RonHooo/bracket-fea/cad/results/portfolio_bracket.png

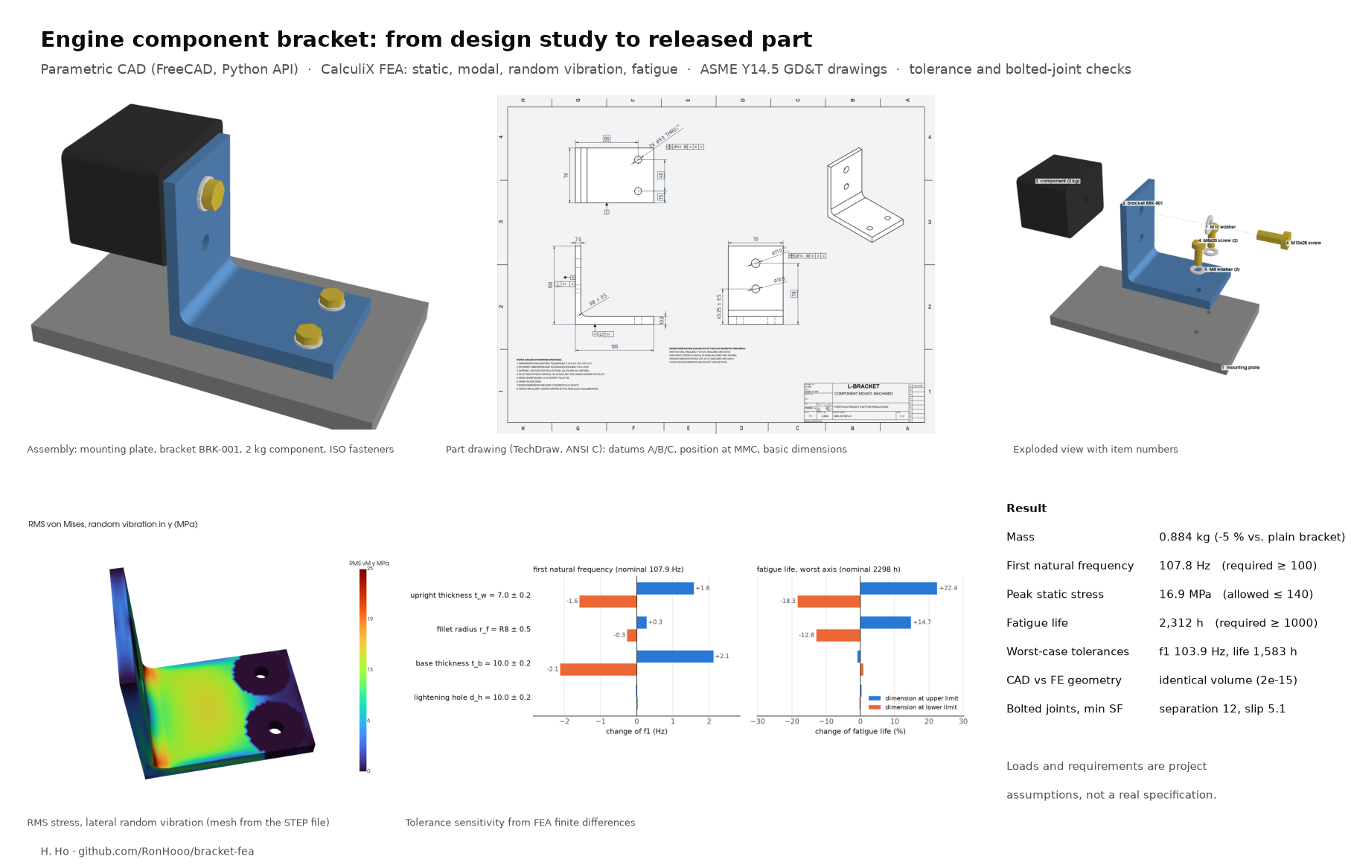
cad/results/portfolio_bracket.png
