RonHooo/bracket-fea/results/designs/baseline/mesh.png

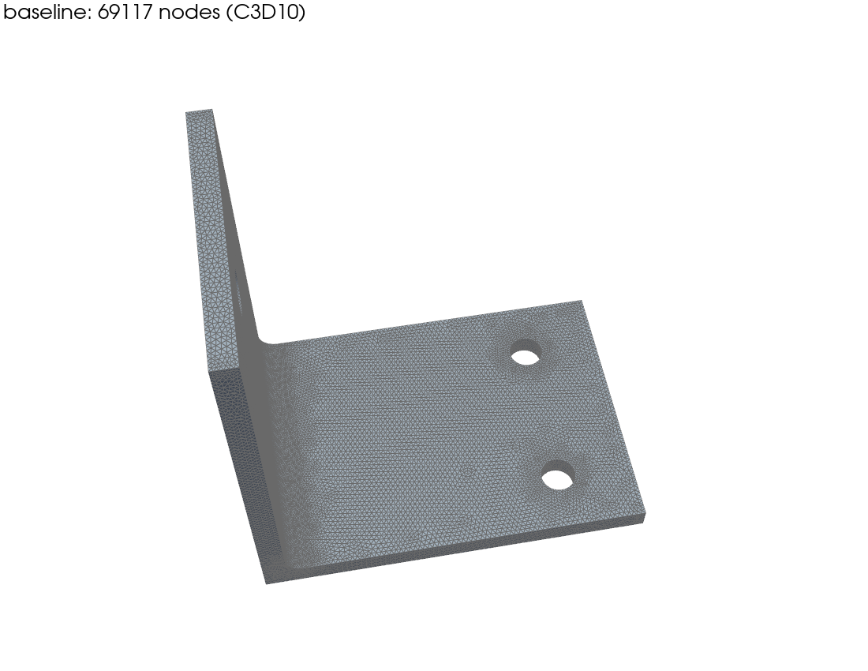
results/designs/baseline/mesh.png
