RonHooo/bracket-fea/results/designs/baseline/mode1.png

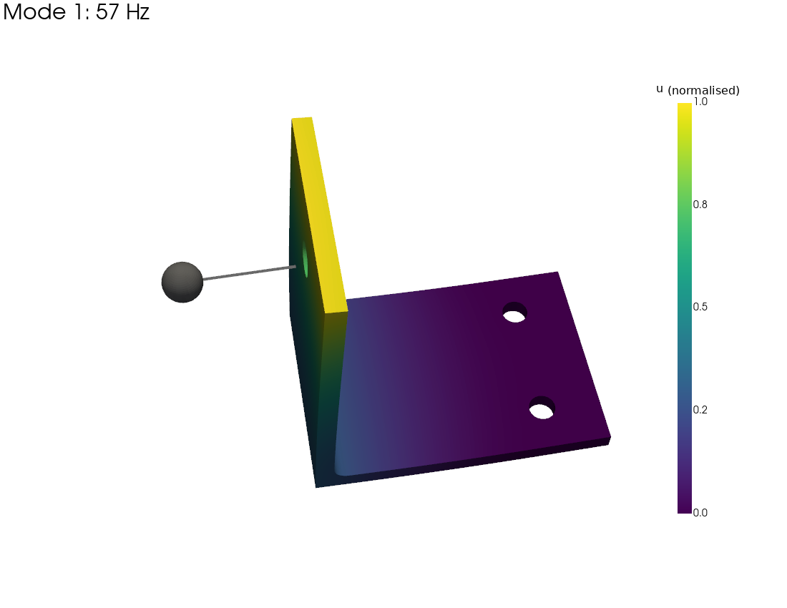
results/designs/baseline/mode1.png
