RonHooo/bracket-fea/results/designs/baseline/psd.png

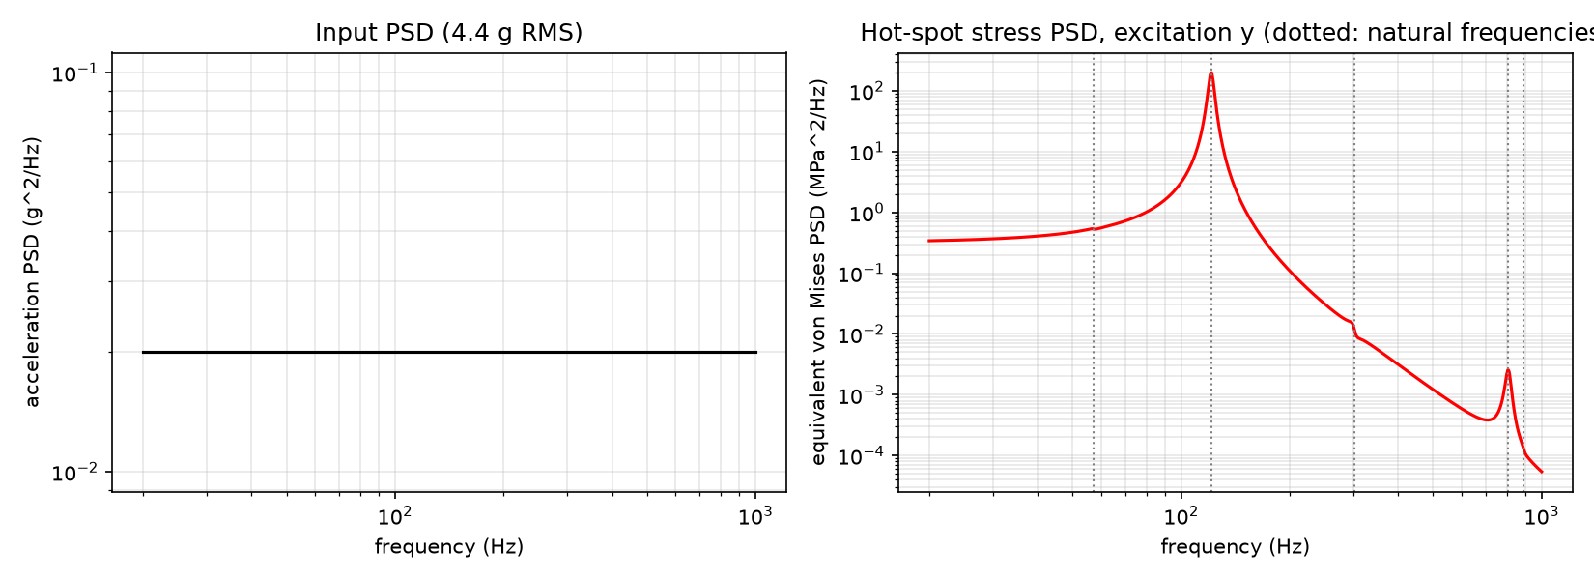
results/designs/baseline/psd.png
