RonHooo/bracket-fea/results/designs/optimum/psd.png

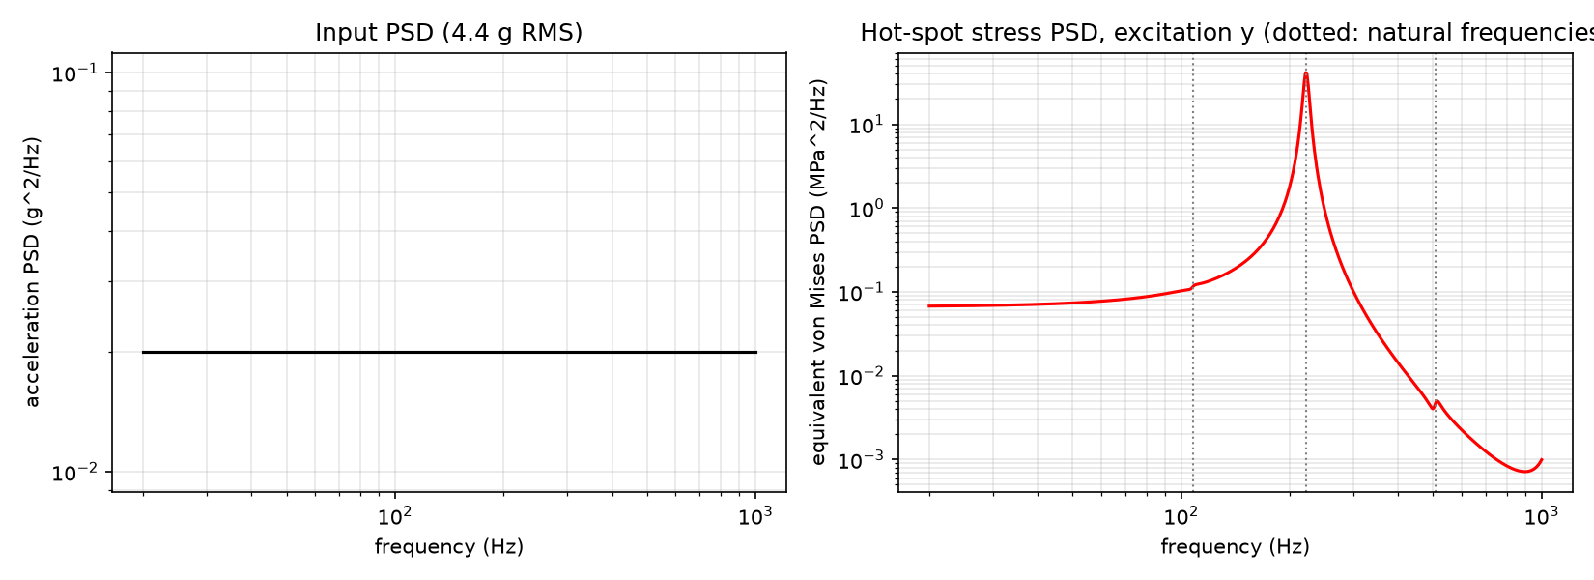
results/designs/optimum/psd.png
