RonHooo/bracket-fea/results/designs/screened_best/mesh.png

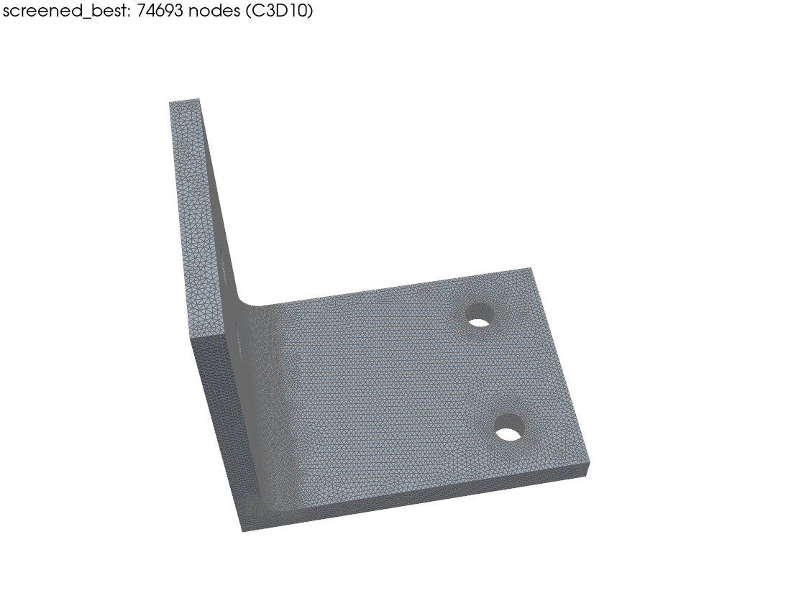
results/designs/screened_best/mesh.png
