RonHooo/bracket-fea/results/verification/v3_spectral_fatigue.png

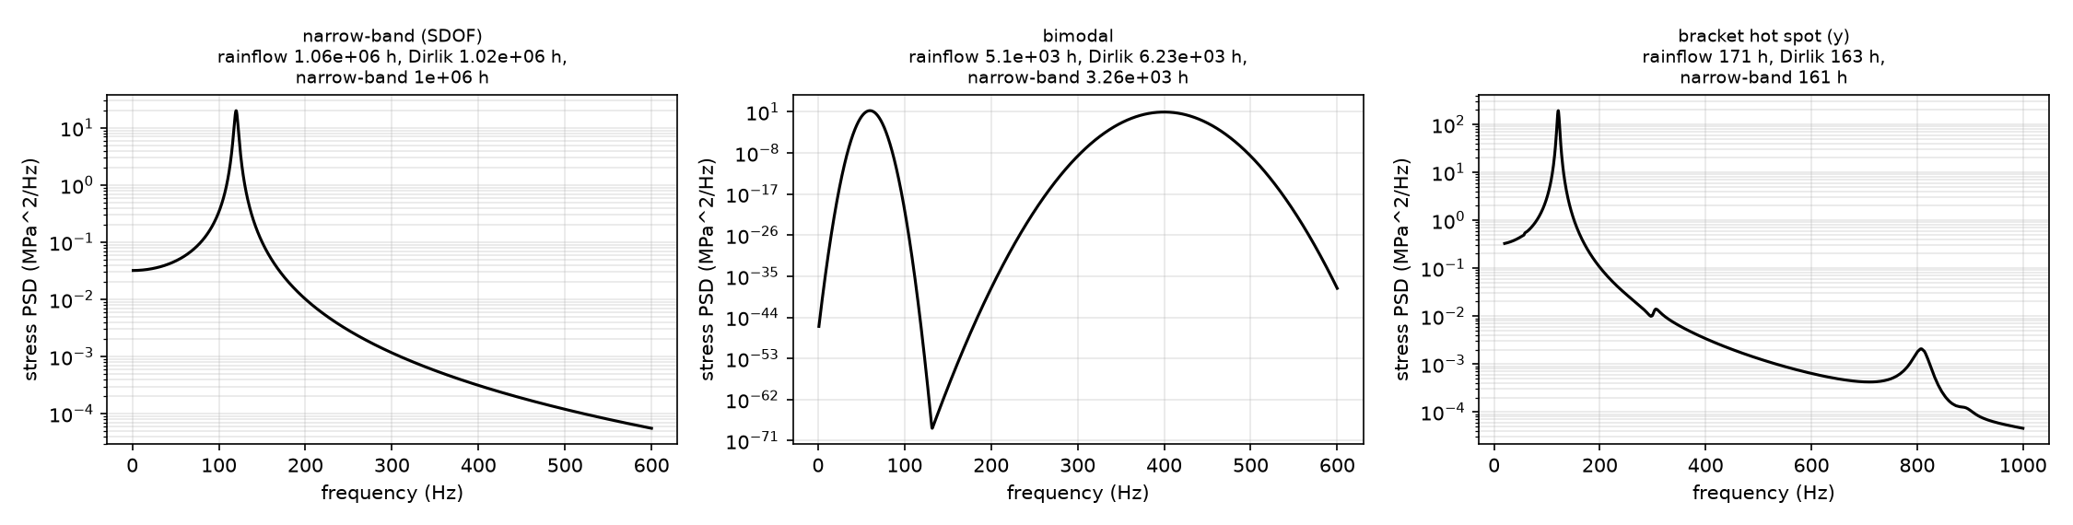
results/verification/v3_spectral_fatigue.png
