RonHooo/bracket-fea/results/optimization/doe_analysis.csv

id | split | t_b | t_w | r_f | L_g | t_g | d_h | mass_kg | vm_max | f1 | f2 | n_nodes | hot_x | hot_y | hot_z | vm_rms_x | life_x_h | vm_rms_y | life_y_h | vm_rms_z | life_z_h | life_h | ok_stress | ok_freq | ok_life | feasible | t_mesh | t_solve | t_parse | t_random | status | vm_max_corner | t_total | ok_life_margin | feasible_margin | gussets | hot_spot
0 | doe | 10.491 | 4.854 | 7.234 | 33.549 | 6.464 | 0.0 | 0.8649765028650915 | 31.17174199776336 | 113.7559 | 235.207 | 71804 | 5.006240934977418 | -24.626285714285693 | 44.10306026001603 | 51.818403576487505 | 10.71829919481946 | 42.69433689501009 | 37.432078286803794 | 58.970350998083404 | 4.436938331240079 | 4.436938331240079 | True | True | False | False | 1.4791292500158306 | 72.6704906670202 | 1.3351316249754746 | 7.361037500028033 | ok | 26.89751146939066 | 83.09834279198549 | False | False | with gussets | gusset tip (on upright)
1 | doe | 8.788 | 4.088 | 8.631 | 32.423 | 5.175 | 13.843 | 0.722956368719305 | 47.12260726848526 | 84.38934 | 179.2263 | 82495 | 4.239895010019635 | -26.93751713125306 | 41.27489593113165 | 70.11977161077186 | 1.4308223184157955 | 57.69585853519348 | 4.939718481326692 | 78.15050105158119 | 0.6561982661966446 | 0.6561982661966446 | True | False | False | False | 1.47461887501413 | 80.14233383297687 | 1.6282844580127858 | 11.082739042001776 | ok | 44.557732651722176 | 94.57847220799886 | False | False | with gussets | gusset tip (on upright)
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
