RonHooo/bracket-fea/cad/out/assembly/bracket_assembly.step

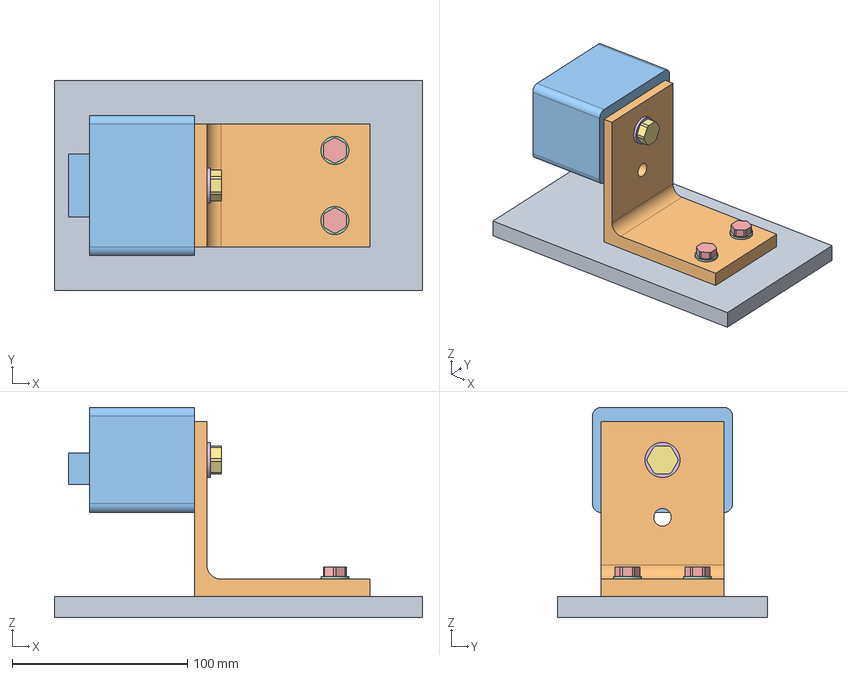
[picture p19: CAD file, 2026-11-05]
cad/out/assembly/bracket_assembly.step
210.0 x 120.0 x 120.0 mm
exp_MountingPlate
exp_Bracket
exp_Component
exp_WasherM8_1
exp_ScrewM8_1
exp_WasherM8_2
exp_ScrewM8_2
exp_WasherM10
exp_ScrewM10
