RonHooo/bracket-fea/cad/out/bracket.step

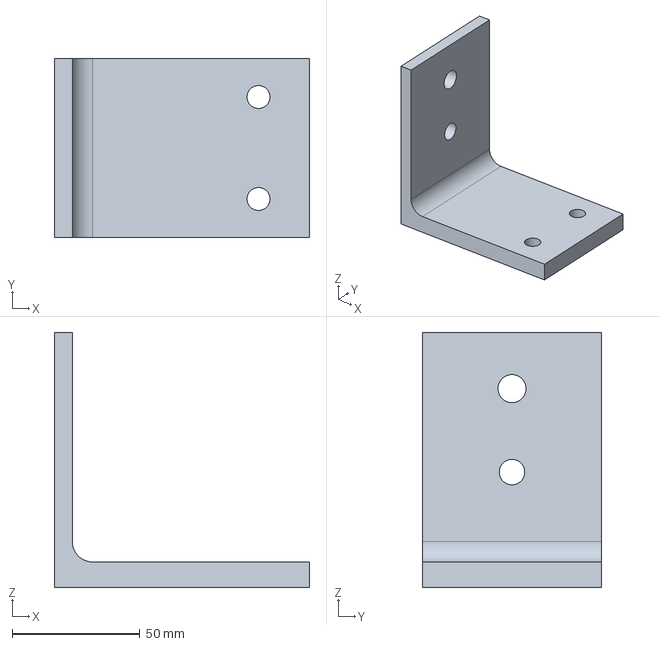
[picture p20: CAD file, 2026-11-05]
cad/out/bracket.step
100.0 x 70.0 x 100.0 mm
