RonHooo/bracket-fea/cad/out/drawings/BRK-001_drawing.FCStd

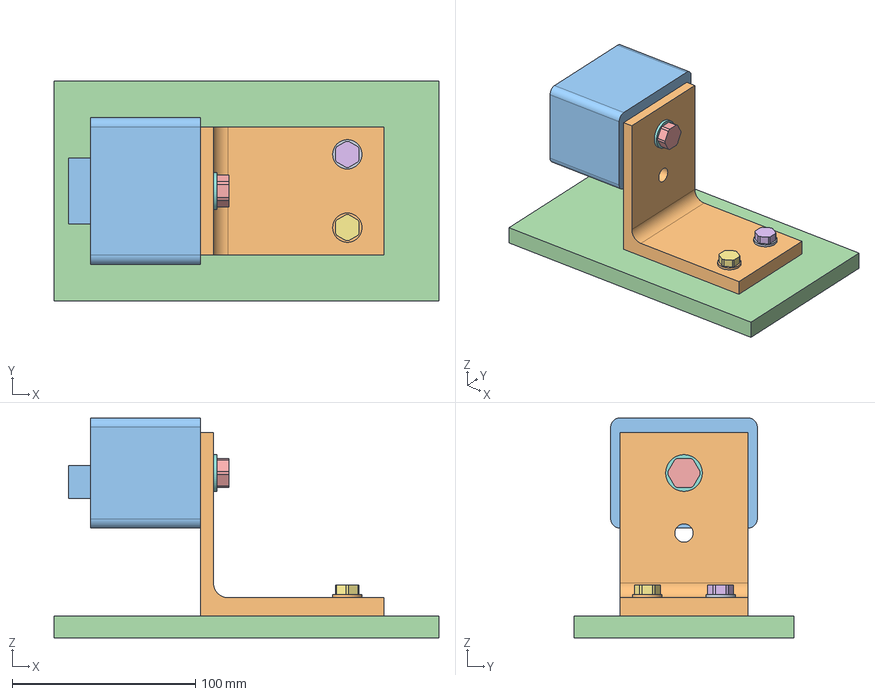
[picture p21: CAD file, 2026-11-05]
cad/out/drawings/BRK-001_drawing.FCStd
210.0 x 120.0 x 120.0 mm
Bracket
asm_Bracket
asm_Component
asm_MountingPlate
asm_ScrewM10
asm_ScrewM8_1
asm_ScrewM8_2
asm_WasherM10
asm_WasherM8_1
asm_WasherM8_2
