RonHooo/bracket-fea/cad/out/assembly/mounting_plate.FCStd

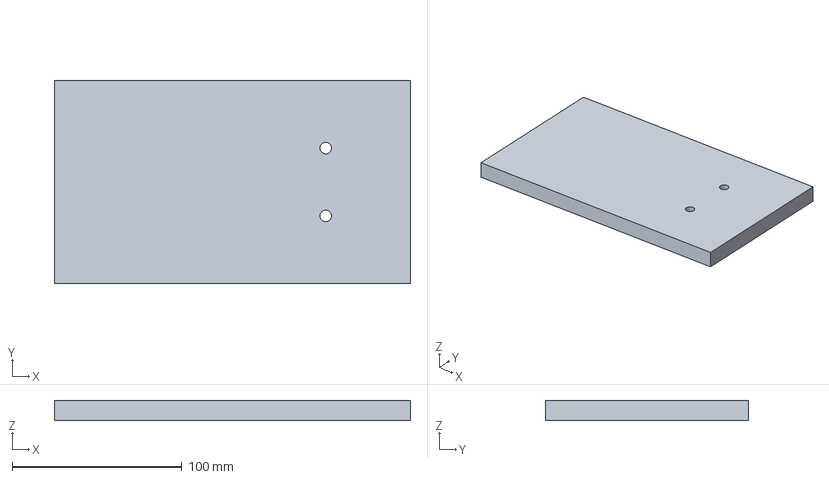
[picture p22: CAD file, 2026-11-05]
cad/out/assembly/mounting_plate.FCStd
210.0 x 120.0 x 12.0 mm
