RonHooo/bracket-fea/cad/out/assembly/component.FCStd

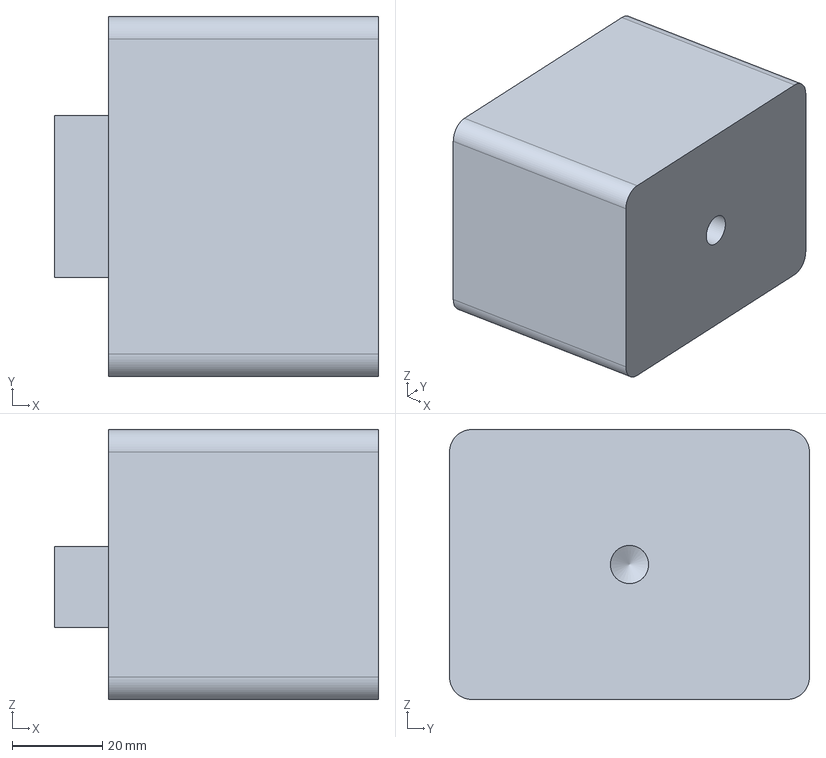
[picture p23: CAD file, 2026-11-05]
cad/out/assembly/component.FCStd
72.0 x 80.0 x 60.0 mm
