RonHooo/bracket-fea/cad/out/assembly/screw_M10x25.FCStd

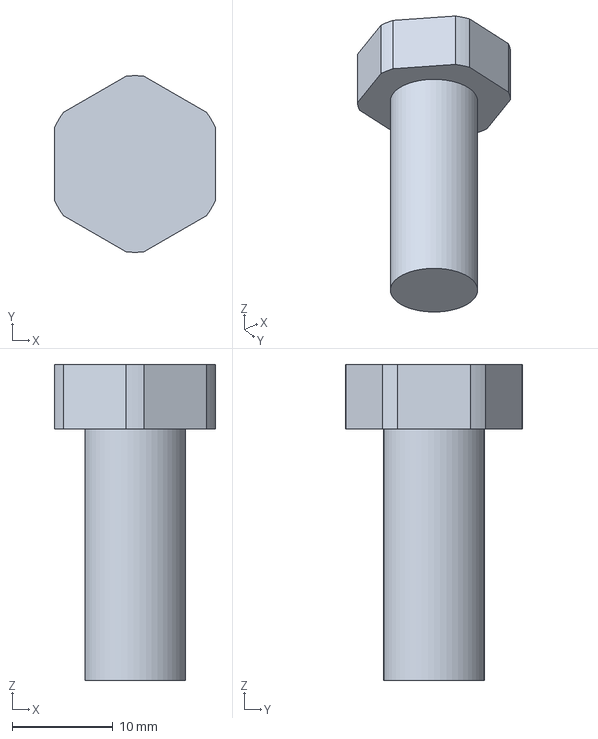
[picture p24: CAD file, 2026-11-05]
cad/out/assembly/screw_M10x25.FCStd
16.0 x 17.5 x 31.4 mm
