RonHooo/bracket-fea/cad/out/assembly/stl/ScrewM8_1.stl

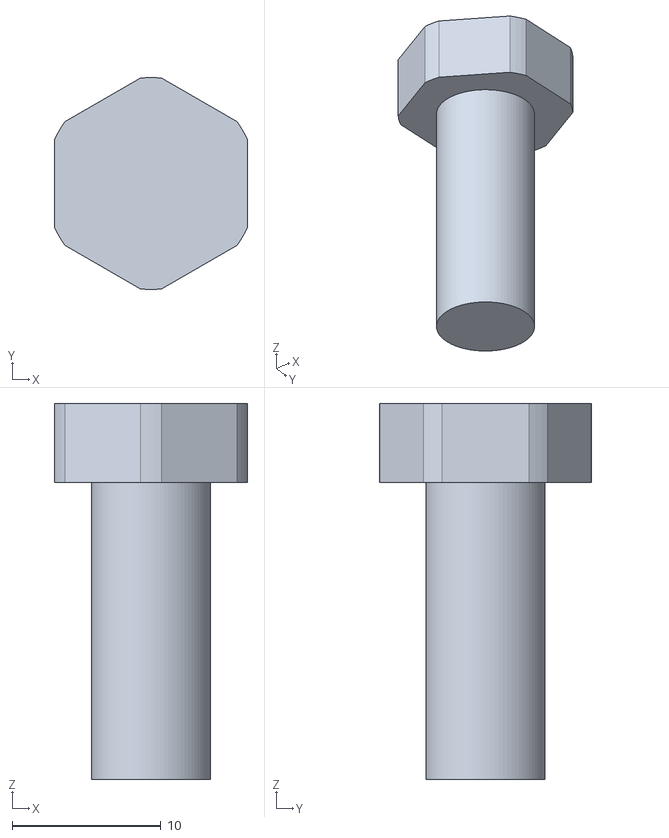
[picture p25: CAD file, 2026-11-05]
cad/out/assembly/stl/ScrewM8_1.stl
13.0 x 14.3 x 25.3
