RonHooo/bracket-fea/cad/out/assembly/stl/WasherM8_2.stl

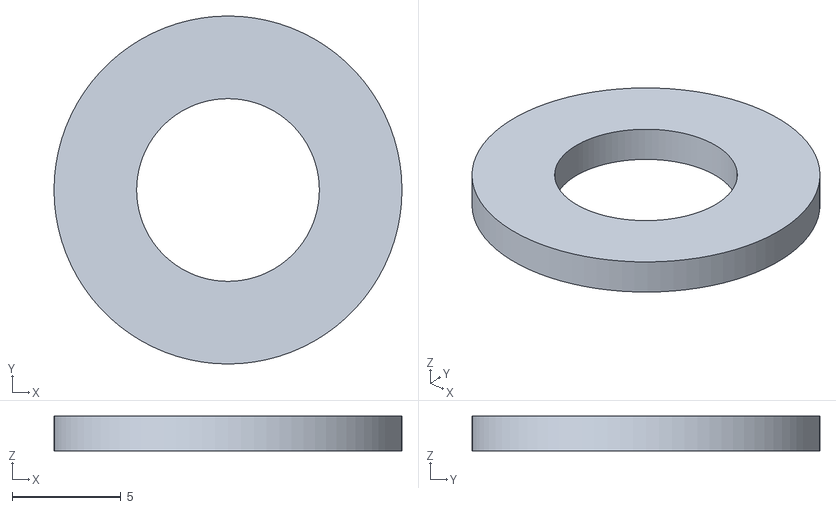
[picture p26: CAD file, 2026-11-05]
cad/out/assembly/stl/WasherM8_2.stl
16.0 x 16.0 x 1.60
