RonHooo/bracket-fea/cad/out/assembly/washer_M10.FCStd

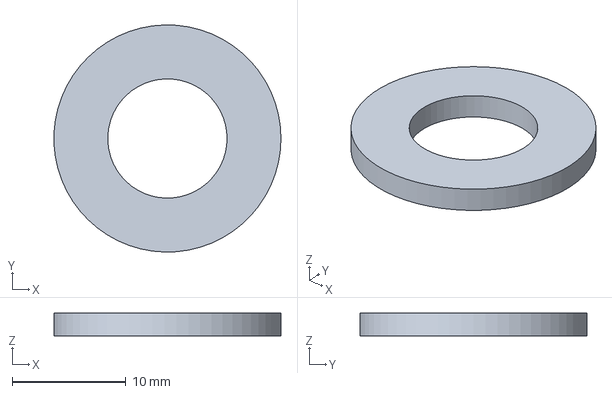
[picture p27: CAD file, 2026-11-05]
cad/out/assembly/washer_M10.FCStd
20.0 x 20.0 x 2.00 mm
