RonHooo/bracket-fea/(list of files, cad)

Other CAD files:
cad/out/assembly/bracket.FCStd
cad/out/assembly/stl/WasherM8_1.stl
cad/out/assembly/stl/ScrewM10.stl
cad/out/assembly/stl/ScrewM8_2.stl
cad/out/assembly/washer_M8.FCStd
cad/out/assembly/screw_M8x20.FCStd
cad/out/assembly/bracket_assembly.FCStd
cad/out/assembly/stl/Bracket.stl
cad/out/assembly/stl/Component.stl
cad/out/assembly/stl/MountingPlate.stl
cad/out/assembly/stl/WasherM10.stl
cad/out/bracket.FCStd
cad/out/bracket.stl
