RonHooo/bracket-fea/cad/results/figures/step_rms_von_mises_y.png

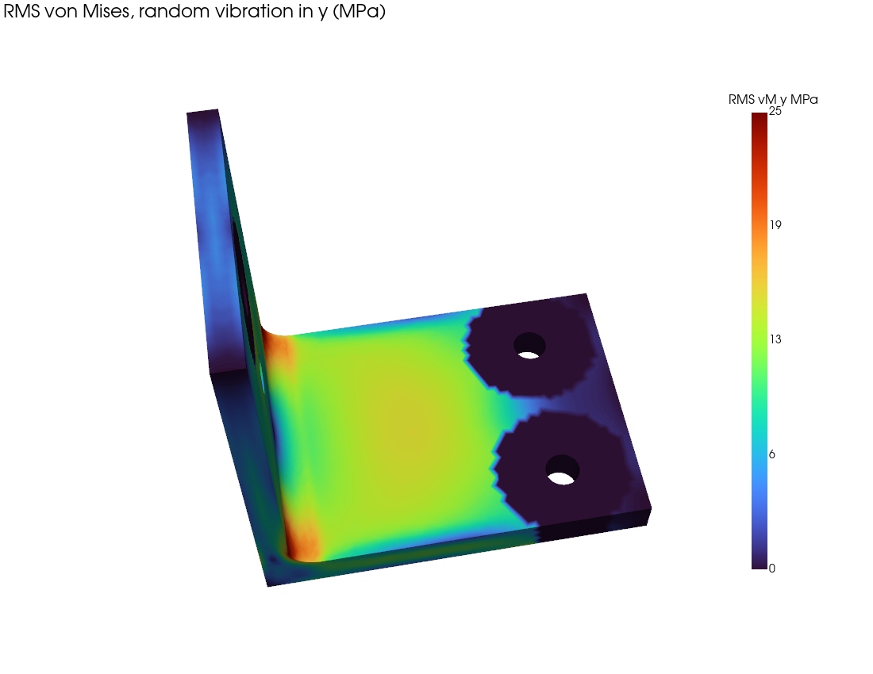
cad/results/figures/step_rms_von_mises_y.png
