RonHooo/bracket-fea/cad/results/figures/step_static_von_mises.png

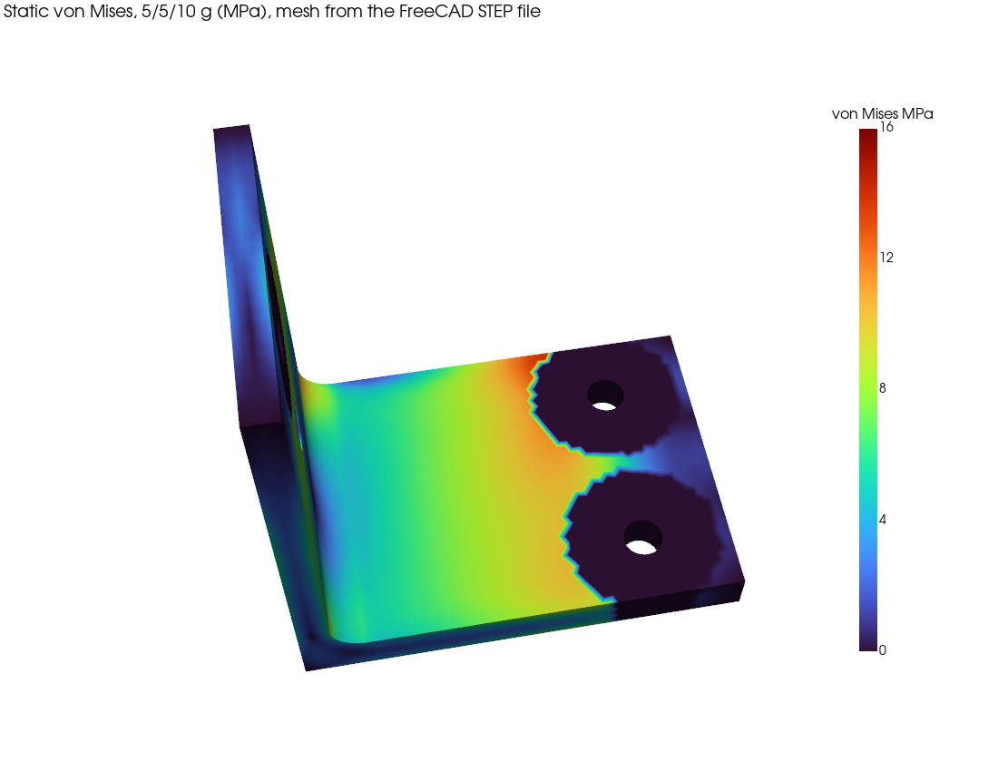
cad/results/figures/step_static_von_mises.png
