RonHooo/bracket-fea/cad/results/tolerance_runs.csv

run | t_b | t_w | r_f | d_h | f1 | life_h | log10_life | vm_max | mass_kg | n_nodes
nominal | 10.0 | 7.0 | 8.0 | 10.0 | 107.8553 | 2297.6988961734883 | 3.361293115606295 | 16.476195348506373 | 0.8837063729193229 | 30478
t_b- | 9.5 | 7.0 | 8.0 | 10.0 | 102.4471 | 2338.8111789588147 | 3.3689951609941002 | 18.345268681551527 | 0.8586540183415194 | 30283
t_b+ | 10.5 | 7.0 | 8.0 | 10.0 | 113.044 | 2236.9453633916364 | 3.3496553767352983 | 16.668525600060462 | 0.908758727497126 | 31053
t_w- | 10.0 | 6.5 | 8.0 | 10.0 | 103.5747 | 1344.7792837640175 | 3.128651010205157 | 18.939608366010898 | 0.8596601469212074 | 29531
t_w+ | 10.0 | 7.5 | 8.0 | 10.0 | 111.4798 | 3691.214784786633 | 3.5671693167030236 | 16.52482401403008 | 0.9077525989174381 | 31219
r_f- | 10.0 | 7.0 | 7.0 | 10.0 | 107.3195 | 1735.7780123698592 | 3.2394941827256463 | 16.57941384489163 | 0.8819375172811261 | 30079
r_f+ | 10.0 | 7.0 | 9.0 | 10.0 | 108.4024 | 3006.4874144265514 | 3.478059390168366 | 16.716825220789353 | 0.8857110759759457 | 31331
d_h- | 10.0 | 7.0 | 8.0 | 9.0 | 107.9783 | 2323.8575480358745 | 3.366209502376595 | 16.43762118268222 | 0.8845263678718178 | 30190
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
