RonHooo/bracket-fea/results/gusset_detail/gusset_detail.csv

design | r_g | mass_kg | f1 | vm_max | life_h | worst_axis | vm_rms | fat_hot_x | fat_hot_y | fat_hot_z | n_nodes
G1 (t_b=8, t_w=6, L_g=40, t_g=6) | 2.0 | 0.8103395284490361 | 101.2466 | 32.064111721368484 | 21.70750955547262 | z | 49.27684694338917 | 46.06098767375244 | 26.42966993319911 | 8.153100790768915 | 58242
G1 (t_b=8, t_w=6, L_g=40, t_g=6) | 3.0 | 0.8128986331680602 | 101.5082 | 28.99869272287644 | 69.36762935069913 | z | 42.41668530973404 | 46.082887618176294 | -23.651834303668863 | 8.233237845589667 | 61893
G1 (t_b=8, t_w=6, L_g=40, t_g=6) | 4.0 | 0.8164352605459286 | 101.823 | 26.969444925880477 | 109.69424208752143 | z | 39.936922526587345 | 46.295890760332306 | 25.689031925898036 | 8.238646735392539 | 62012
G1 (t_b=8, t_w=6, L_g=40, t_g=6) | 5.0 | 0.8209228033343849 | 102.1873 | 25.013408834932914 | 205.4629701363684 | z | 36.86929713612169 | 46.79063511855585 | 24.272738324104857 | 8.166730700870907 | 62727
G1 (t_b=8, t_w=6, L_g=40, t_g=6) | 6.0 | 0.8264238433702318 | 102.5807 | 24.423750123771626 | 312.01012612160304 | z | 34.90055608137942 | 46.757965945460825 | 23.8797970791109 | 8.254011711680372 | 65397
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
