RonHooo/bracket-fea/results/mesh_convergence/mesh_convergence.csv

design | scale | h_min | h_max | n_nodes | vm_max | f1 | f2 | worst_axis | vm_rms | life_h | vm_bolt_zone | hot_x | hot_y | hot_z | t_solve
A_no_gusset | 2.0 | 3.0 | 7.199999999999999 | 6368 | 44.11526849510768 | 57.4103 | 122.2891 | y | 36.421890494807435 | 241.6373970504296 | 94.71385993066099 | 66.15583583594639 | 35.0 | 0.0 | 1.0051457920053508
A_no_gusset | 1.4 | 2.0999999999999996 | 5.039999999999999 | 12437 | 44.41506826736069 | 57.29031 | 121.7496 | y | 36.77053493269982 | 225.6755364292862 | 100.20352993062559 | 67.49725135900218 | 32.97578265707317 | 0.0 | 2.339216332999058
A_no_gusset | 1.0 | 1.5 | 3.5999999999999996 | 27620 | 44.59807964471695 | 57.2003 | 121.4209 | y | 38.382619343525455 | 162.79535575436876 | 115.43308977502842 | 68.49054795661746 | 35.0 | 0.0 | 7.127789375022985
A_no_gusset | 0.7 | 1.0499999999999998 | 2.5199999999999996 | 69117 | 44.84998346545803 | 57.16625 | 121.2165 | y | 39.09837719879388 | 141.61592930608177 | 125.44807847315796 | 68.4258115742827 | 33.932372398690276 | 0.0 | 29.075028499995824
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
