RonHooo/bracket-fea/results/optimization/exclusion_sensitivity.csv

design | exclusion_radius_over_d | vm_max | life_h | worst_axis | vm_rms
lightest feasible (DOE id 220) | 1.5 | 17.170072730626543 | 3262.3802348025865 | y | 23.975578240987492
lightest feasible (DOE id 220) | 2.0 | 16.773717967665444 | 3262.3802348025865 | y | 23.975578240987492
lightest feasible (DOE id 220) | 2.5 | 16.306992303071052 | 3262.3802348025865 | y | 23.975578240987492
lightest feasible (DOE id 220) | 3.0 | 16.306992303071052 | 3262.3802348025865 | y | 23.975578240987492
plain t=9 | 1.5 | 21.195723087620156 | 1659.0517912630228 | y | 26.306815735502813
plain t=9 | 2.0 | 20.68647124429199 | 1659.0517912630228 | y | 26.306815735502813
plain t=9 | 2.5 | 19.17411774661115 | 1659.0517912630228 | y | 26.306815735502813
plain t=9 | 3.0 | 16.51276706986614 | 1659.0517912630228 | y | 26.306815735502813
