RonHooo/bracket-fea/cad/results/figures/bracket_render.png

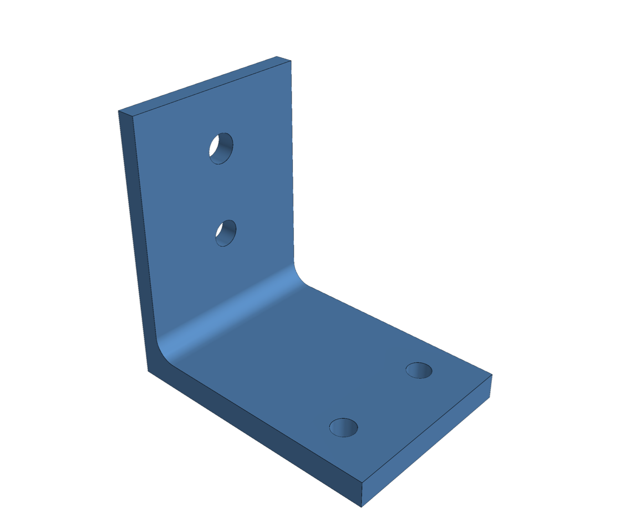
cad/results/figures/bracket_render.png
