RonHooo/bracket-fea/results/figures/v1_cantilever_errors.png

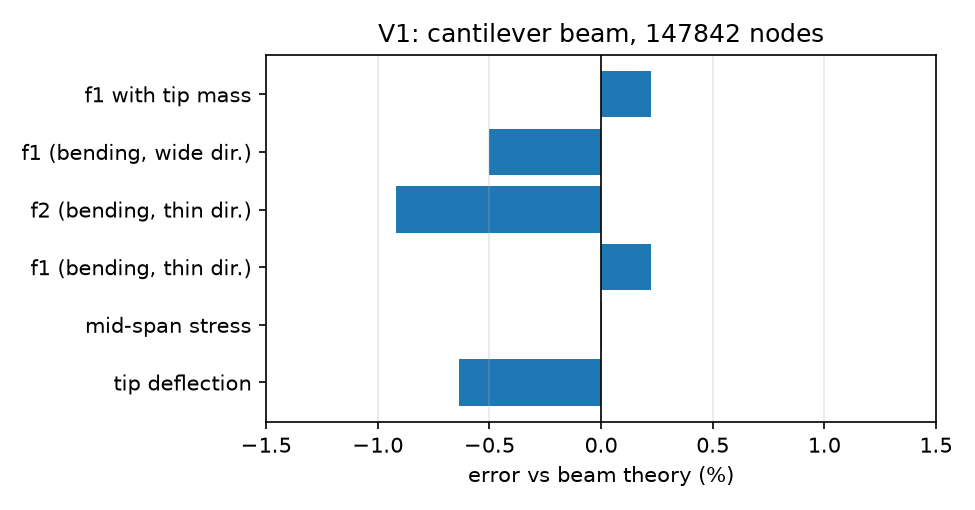
results/figures/v1_cantilever_errors.png
