RonHooo/bracket-fea/results/optimization/hot_spot_locations.png

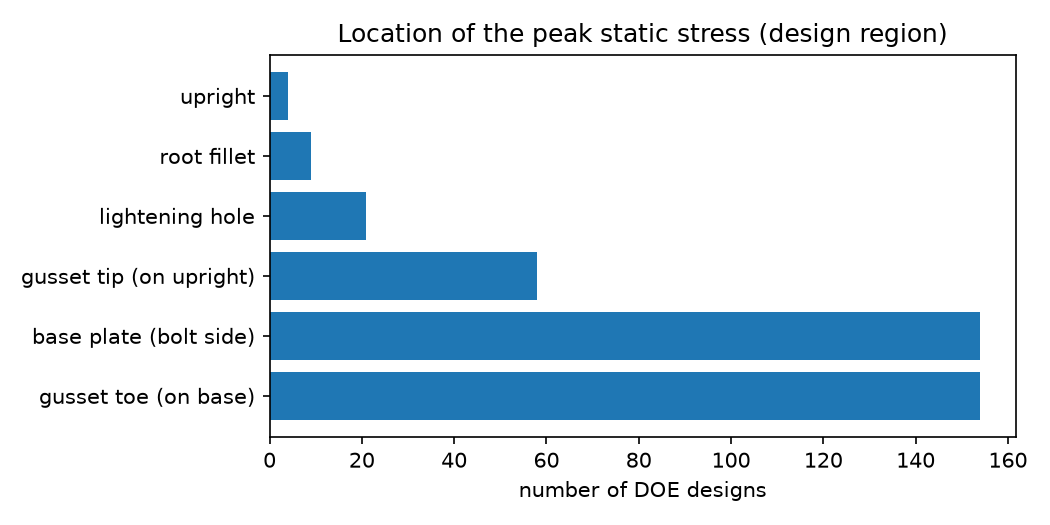
results/optimization/hot_spot_locations.png
