RonHooo/bracket-fea/results/optimization/parameter_effects.png

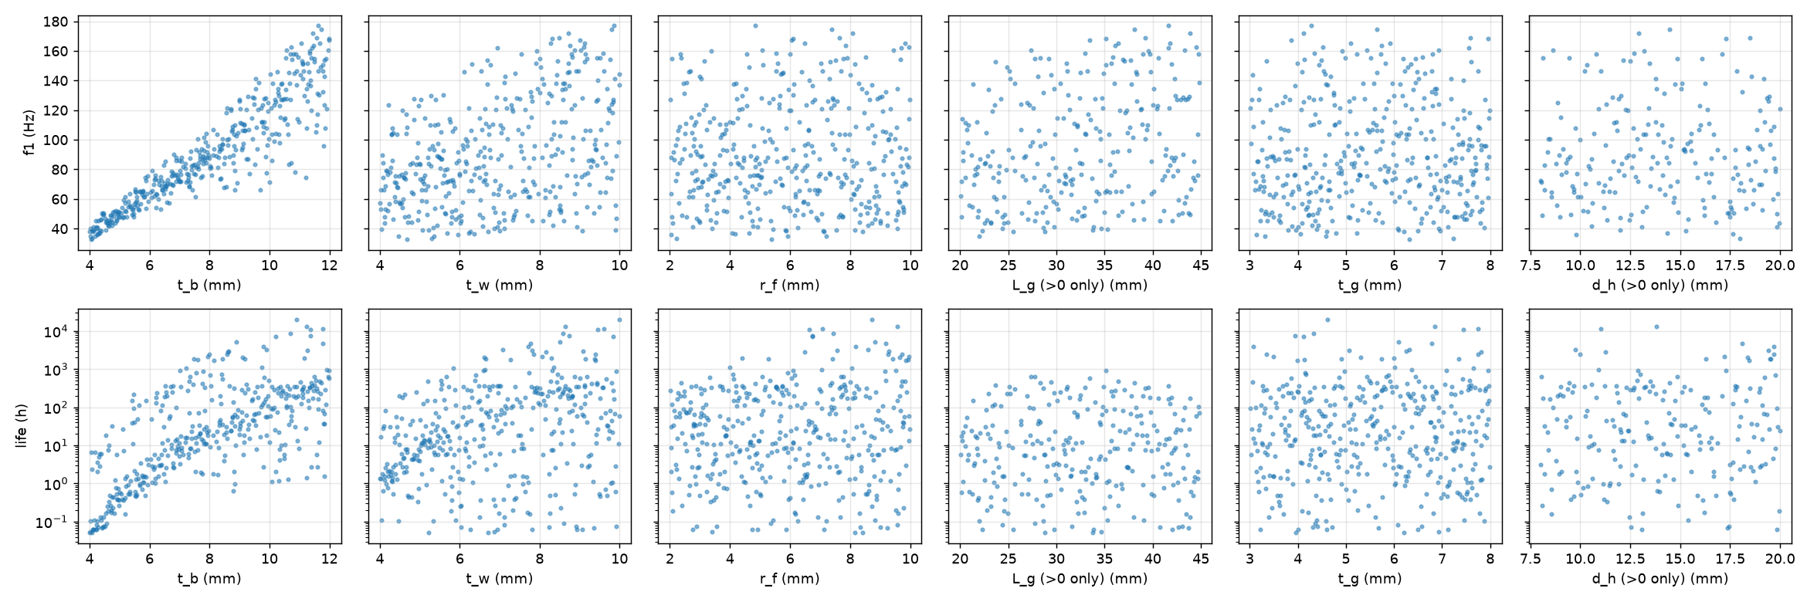
results/optimization/parameter_effects.png
