RonHooo/bracket-fea/results/verification/v3_ssd_vs_modal.png

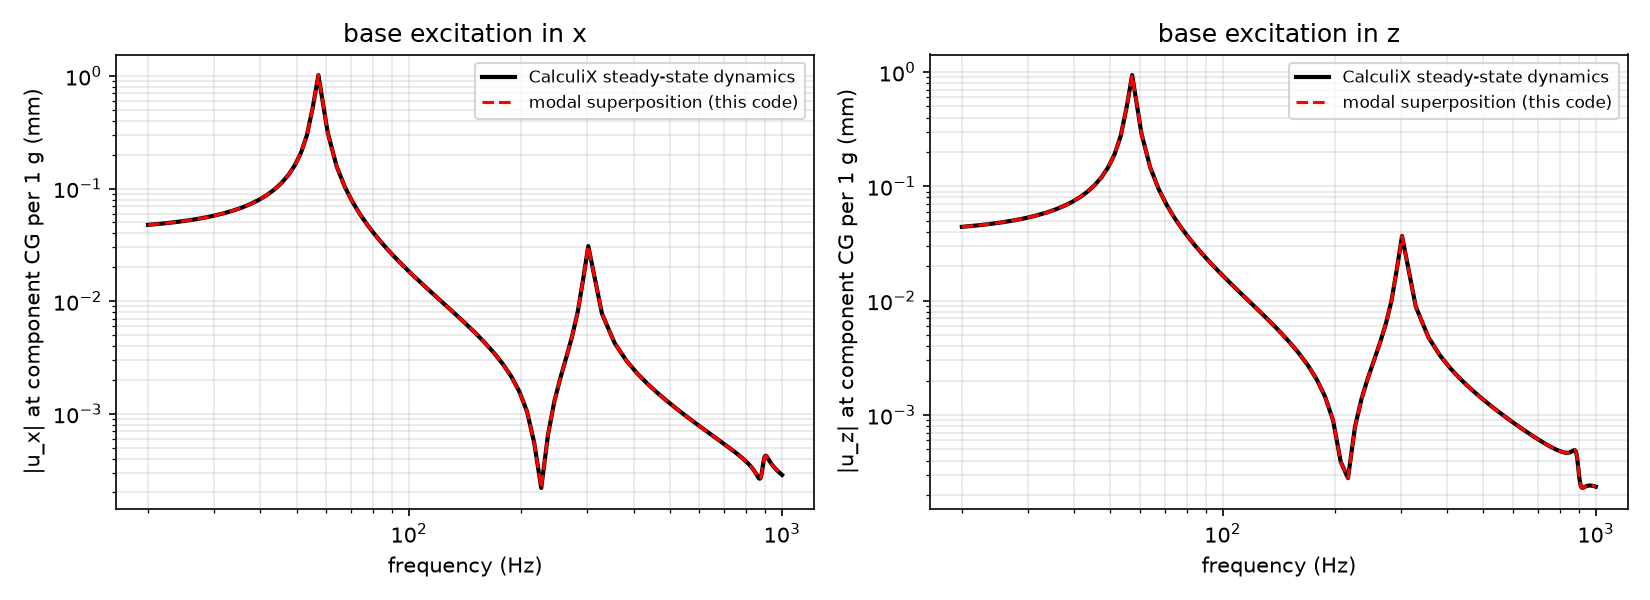
results/verification/v3_ssd_vs_modal.png
