RonHooo/bracket-fea/cad/out/drawings/ASM-001_assembly_drawing.pdf

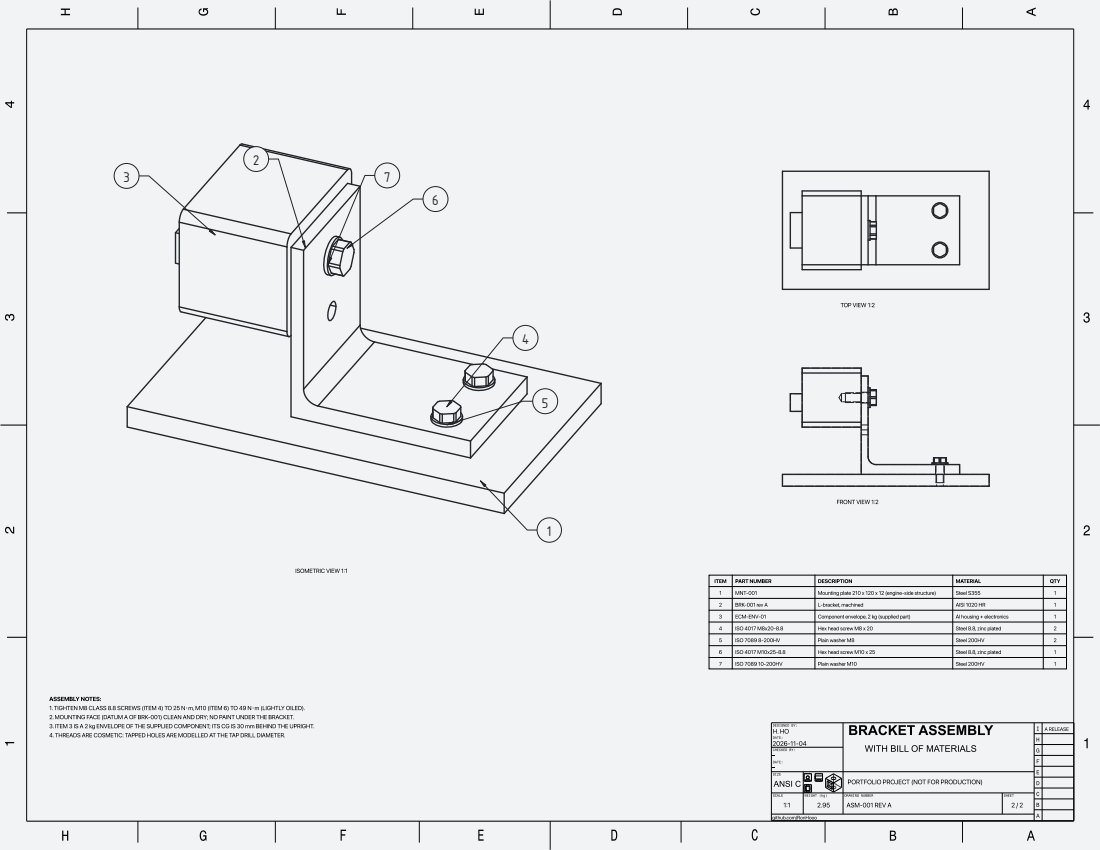
[picture p35: page 1]
