RonHooo/bracket-fea/cad/out/drawings/BRK-001_part_drawing.pdf

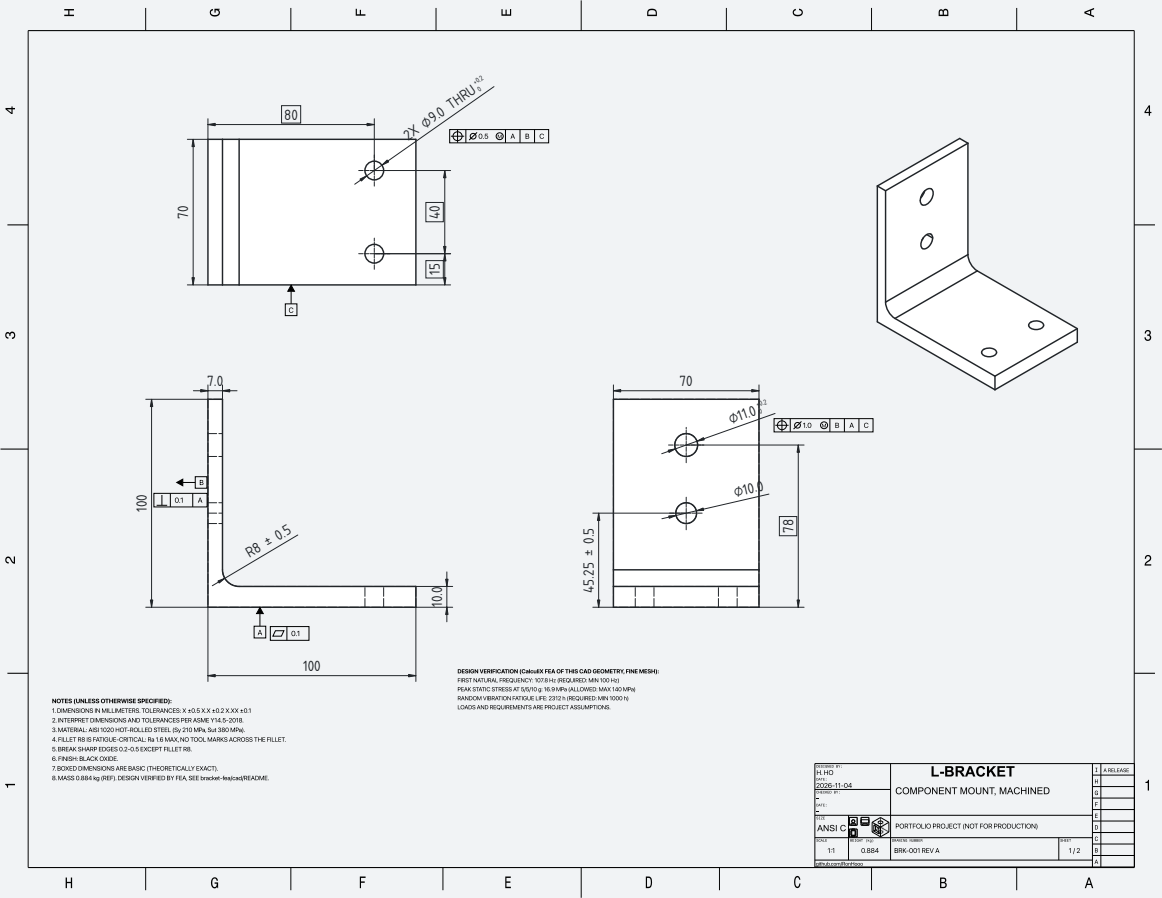
[picture p36: page 1]
THRU +0.2 0
