RonHooo/bracket-fea/(commit log)

2026-11-04 Vibration fatigue FEA of a parametric L-bracket (gmsh + CalculiX)
    Static, modal, random-vibration and Dirlik/Miner fatigue analysis of a
    parametric steel bracket, verification cases V1-V3 and hand calculations,
    mesh convergence, a 400-design Latin hypercube study, the gusset-fillet
    detail study and the excluded-zone sensitivity check, with results and
    figures.
    [doe_analysis.csv, doe_results.csv, exclusion_sensitivity.csv, gusset_detail.csv, lightest_feasible.csv, mesh_convergence.csv, plain_reference.csv, v1_cantilever.csv]
2026-11-05 Add FreeCAD design package for the released bracket
    Parametric FreeCAD model built through the Python API (spreadsheet-driven,
    fully constrained sketches), an assembly with ISO fasteners, interference
    check and BOM, ASME Y14.5 part and assembly drawings, FEA re-run from the
    exported STEP file, FEA-based tolerance study, bolted-joint hand checks and
    a one-page portfolio summary. geometry.py gains mesh_volume() so imported
    STEP geometry can use the same meshing as the native model.
    [BRK-001_drawing.FCStd, Bracket.stl, Component.stl, MountingPlate.stl, ScrewM10.stl, ScrewM8_1.stl, ScrewM8_2.stl, WasherM10.stl]
